gbrown128/wallie-pdb/README.md

# WALL-IE Power Distribution Board
Power Distribution Board for Team Congo's Bio Inspired Robots project, "WALL-IE".

Current Bio-Inspired Robots students please feel free to ask me questions about this design and options for your robot in the Issues section!
