gbrown128/wallie-pdb/PDF/cutoff-hardware.pdf

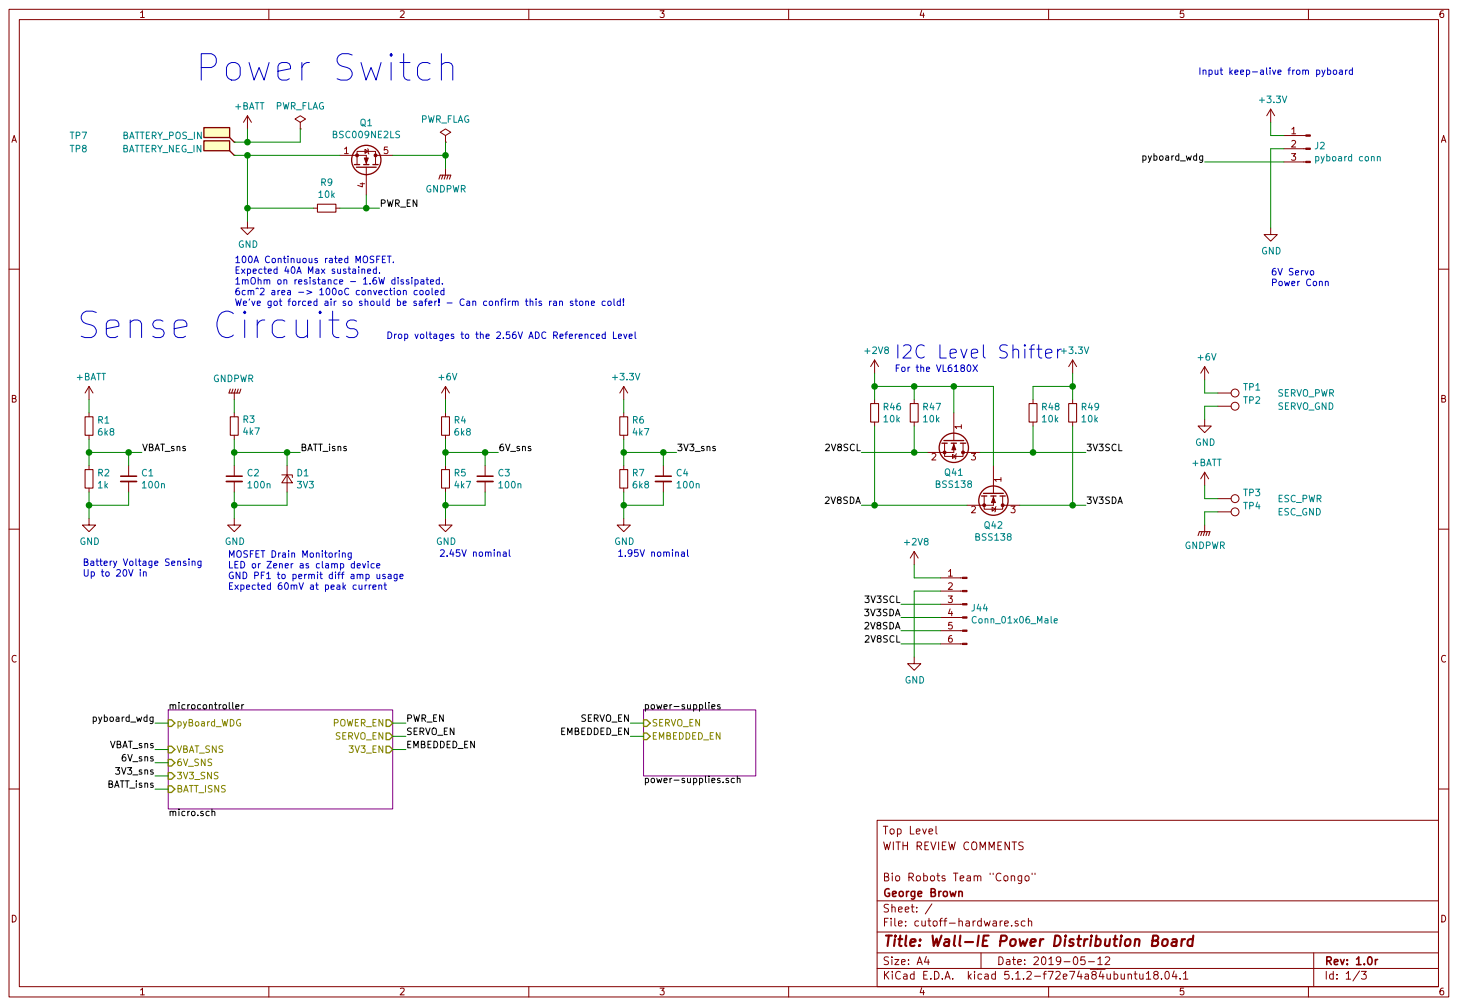
[picture p1: page 1]

Input keep-alive from pyboard

EMBEDDED_EN GND
100A Continuous rated MOSFET. Expected 40A Max sustained.

1mOhm on resistance - 1.6W dissipated. 6cm^2 area -> 100oC convection cooled We've got forced air so should be safer! - Can confirm this ran stone cold! SERVO_EN

LED or Zener as clamp device
GND PF1 to permit diff amp usage

Bio Robots Team "Congo" WITH REVIEW COMMENTS

File: cutoff-hardware.sch Sheet: / George Brown

Id: 1/3 Title: Wall-IE Power Distribution Board

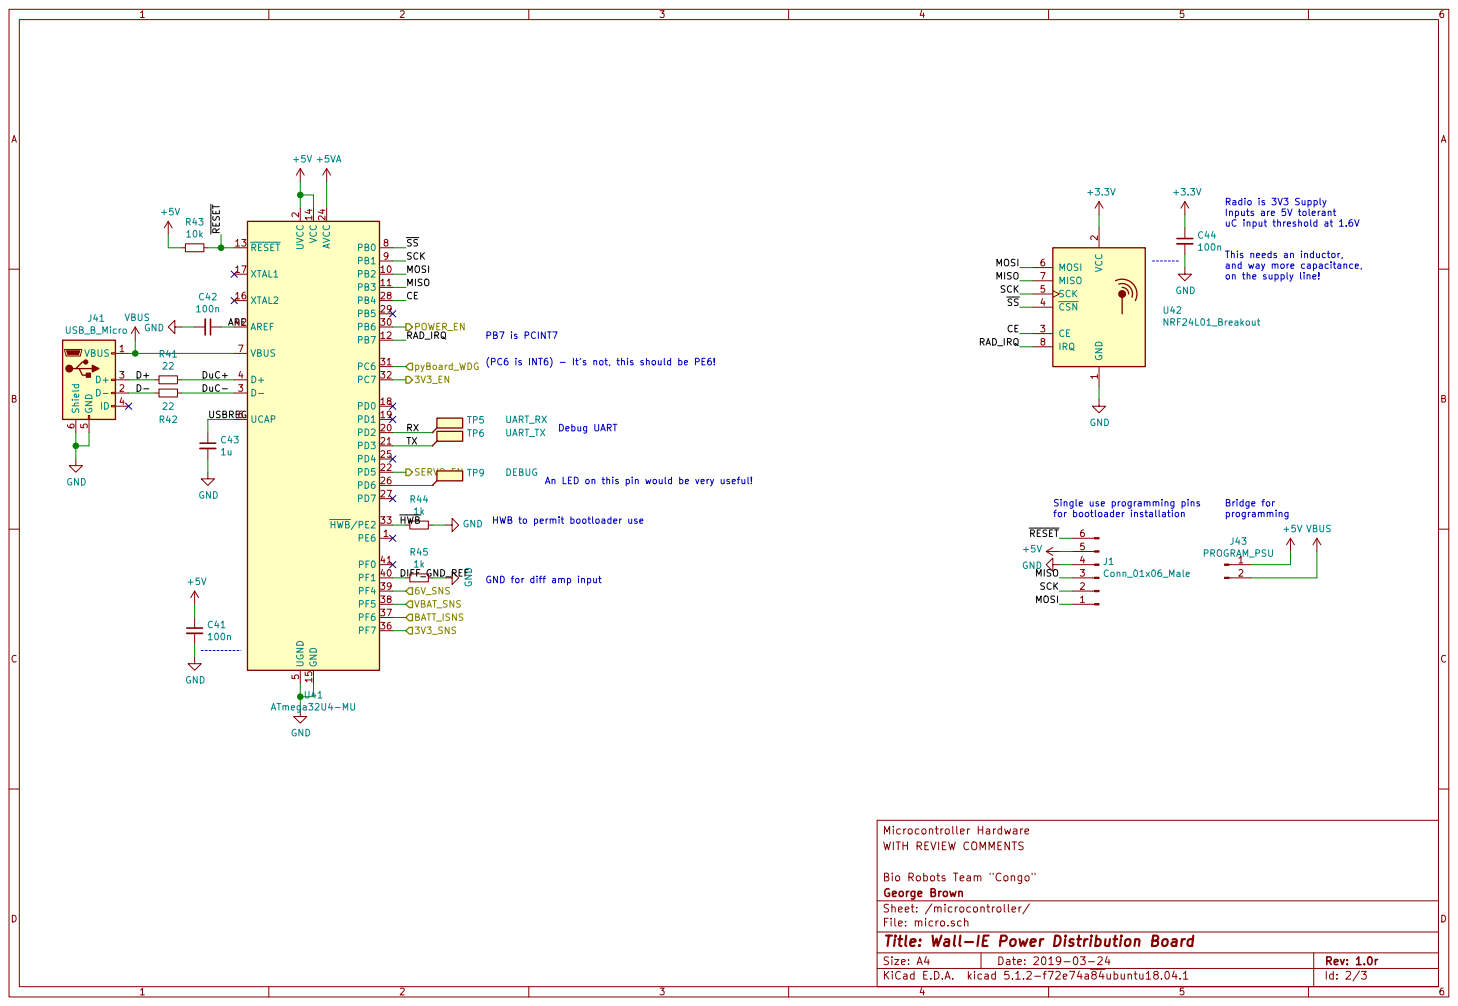
[picture p2: page 2]

Radio is 3V3 Supply
Inputs are 5V tolerant
uC input threshold at 1.6V

2 PD2 20 PD3 21 PD5 22 AVCC 24 PD4 25 PD6 26 PD7 27 PB4 28 PB5 29 D- 3 PB6 30 PC6 31 PC7 32 HWB/PE2 33 PF7 36 PF6 37 PF5 38 PF4 39 D+ 4 PF1 40 PF0 41 AREF 42 UGND

2 CE 3 CSN 4 SCK 5 MOSI 6 MISO 7

on the supply line!

GND for diff amp input PB7 is PCINT7 USBREG

An LED on this pin would be very useful!

RESETSingle use programming pins

HWB to permit bootloader use
+5V GND

Bio Robots Team "Congo" WITH REVIEW COMMENTS Microcontroller Hardware

File: micro.sch Sheet: /microcontroller/ George Brown

Id: 2/3 Title: Wall-IE Power Distribution Board

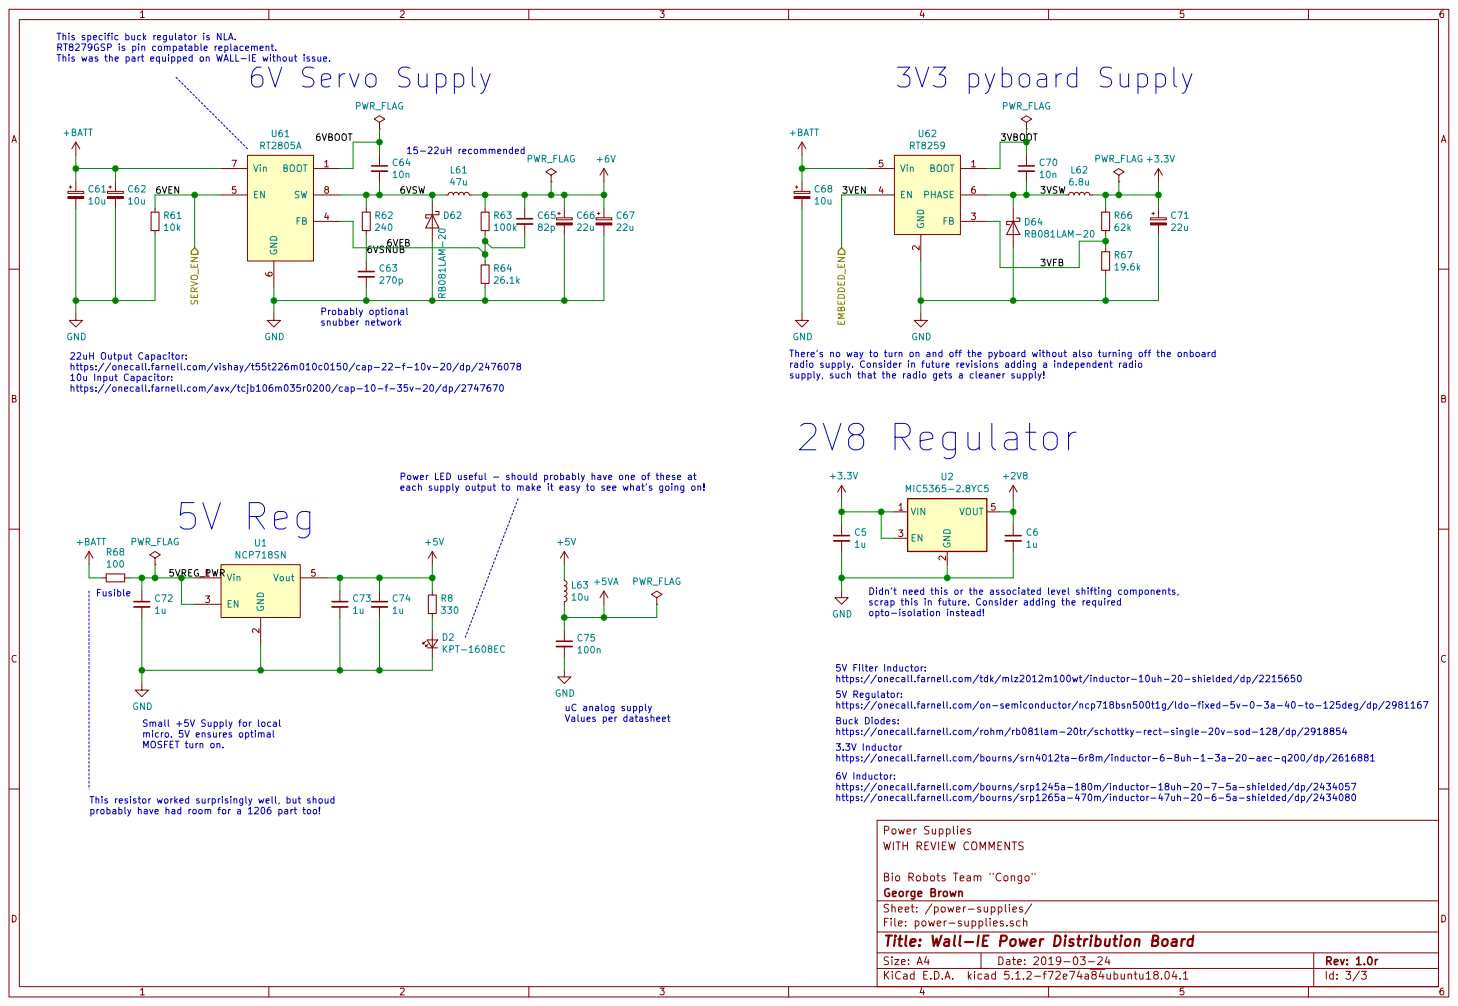
[picture p3: page 3]

This specific buck regulator is NLA.
RT8279GSP is pin compatable replacement.
This was the part equipped on WALL-IE without issue.

2 FB 3 EN 4 Vin 5 PHASE 6 U62 RT8259 R66

2 EN 3 VOUT 5 U2 MIC5365-2.8YC5 GND GND GND GND GND
22uH Output Capacitor:
https://onecall.farnell.com/vishay/t55t226m010c0150/cap-22-f-10v-20/dp/2476078
10u Input Capacitor:
https://onecall.farnell.com/avx/tcjb106m035r0200/cap-10-f-35v-20/dp/2747670 5VREG_PWR

There's no way to turn on and off the pyboard without also turning off the onboard
radio supply. Consider in future revisions adding a independent radio
supply, such that the radio gets a cleaner supply!
2V8 Regulator

Power LED useful - should probably have one of these at
each supply output to make it easy to see what's going on!

Didn't need this or the associated level shifting components,
scrap this in future. Consider adding the required
opto-isolation instead!

5V Filter Inductor: https://onecall.farnell.com/tdk/mlz2012m100wt/inductor-10uh-20-shielded/dp/2215650

5V Regulator:
https://onecall.farnell.com/on-semiconductor/ncp718bsn500t1g/ldo-fixed-5v-0-3a-40-to-125deg/dp/2981167
Buck Diodes: https://onecall.farnell.com/rohm/rb081lam-20tr/schottky-rect-single-20v-sod-128/dp/2918854

Small +5V Supply for local

3.3V Inductor https://onecall.farnell.com/bourns/srn4012ta-6r8m/inductor-6-8uh-1-3a-20-aec-q200/dp/2616881

This resistor worked surprisingly well, but shoud
probably have had room for a 1206 part too!

https://onecall.farnell.com/bourns/srp1265a-470m/inductor-47uh-20-6-5a-shielded/dp/2434080

Power Supplies
Bio Robots Team "Congo" WITH REVIEW COMMENTS

George Brown
Sheet: /power-supplies/
File: power-supplies.sch
Id: 3/3 Title: Wall-IE Power Distribution Board
