gbrown128/wallie-pdb/cutoff-hardware.kicad_pcb

## KiCad design cutoff-hardware.kicad_pcb (2019-05-12)

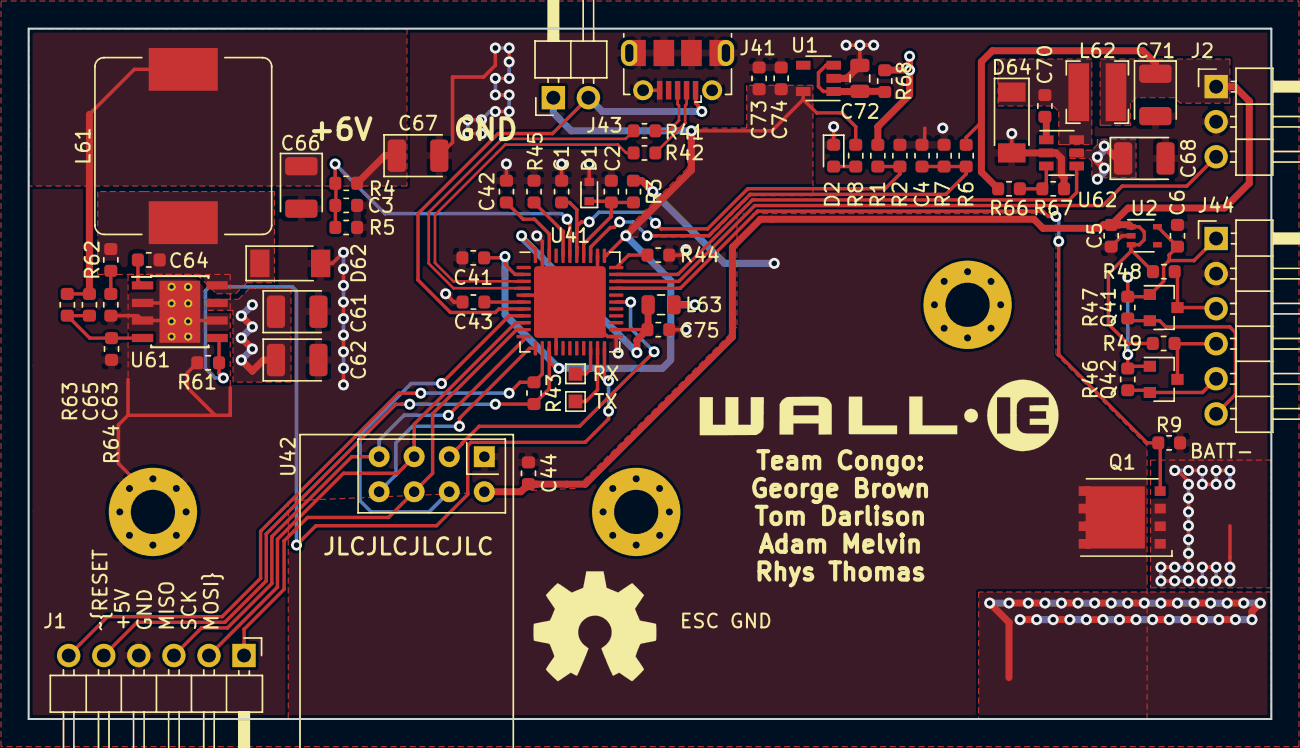
[picture p4: board cutoff-hardware.kicad_pcb from above]

Board: 2 copper layers, 90.0 x 50.0 mm, 72 parts (0 on the bottom side), 47 nets.

Parts:
C1, C2, C3, C4, C41, C42, C44, C75: 100n; C_0603_1608Metric
C5, C6, C43, C73, C74: 1u; C_0603_1608Metric
C61, C62, C68: 10u; CP_EIA-3528-21_Kemet-B
C63: 270p; C_0603_1608Metric
C64, C70: 10n; C_0603_1608Metric
C65: 82p; C_0603_1608Metric
C66, C67, C71: 22u; CP_EIA-3528-12_Kemet-T
C72: 1u; C_0805_2012Metric
D1: 3V3; D_SOD-523
D2: KPT-1608EC; LED_0603_1608Metric
D62, D64: RB081LAM-20; D_SOD-128
J1, J44: Conn_01x06_Male; PinHeader_1x06_P2.54mm_Horizontal
J2: pyboard conn; PinHeader_1x03_P2.54mm_Horizontal
J41: USB_B_Micro; USB_Micro-B_Molex-105017-0001
J43: PROGRAM_PSU; PinHeader_1x02_P2.54mm_Horizontal
L61: 47u; L_Bourns_SRP1265
L62: 6.8u; L_Bourns-SRN4012
L63: 10u; L_0805_2012Metric
Q1: BSC009NE2LS; TDSON-8-1
Q41, Q42: BSS138; SOT-23
R1, R4, R7: 6k8; R_0603_1608Metric
R2, R44, R45: 1k; R_0603_1608Metric
R3, R5, R6: 4k7; R_0603_1608Metric
R8: 330; R_0603_1608Metric
R9, R43, R46, R47, R48, R49, R61: 10k; R_0603_1608Metric
R41, R42: 22; R_0603_1608Metric
R62: 240; R_0603_1608Metric
R63: 100k; R_0603_1608Metric
R64: 26.1k; R_0603_1608Metric
R66: 62k; R_0603_1608Metric
R67: 19.6k; R_0603_1608Metric
R68: 100; R_0603_1608Metric
RX: UART_RX; TestPoint_Pad_1.0x1.0mm
TX: UART_TX; TestPoint_Pad_1.0x1.0mm
U1: NCP718SN; SOT-23-5
U2: MIC5365-2.8YC5; SOT-353_SC-70-5
U41: ATmega32U4-MU; QFN-44-1EP_7x7mm_P0.5mm_EP5.2x5.2mm
U42: NRF24L01_Breakout; nRF24L01_Breakout
U61: RT2805A; TI_SO-PowerPAD-8_ThermalVias
U62: RT8259; SOT-23-6

Connections:
+2V8: C6.1, J44.1, Q41.1, Q42.1, R46.1, R47.1, U2.5
+3V3: C5.1, C44.1, C71.1, J2.1, L62.2, R6.1, R48.1, R49.1, R66.1, U2.1, U2.3, U42.2
+5V: C41.1, C73.1, C74.1, J1.5, J43.1, L63.1, R8.1, R43.2, U1.5, U41.2, U41.14, U41.34
+5VA: C75.1, L63.2, U41.24, U41.44
+6V: C65.1, C66.1, C67.1, L61.2, R4.1, R63.1
+BATT: C61.1, C62.1, C68.1, R1.1, R68.2, U61.7, U62.5
/2V8SCL: J44.6, Q41.2, R47.2
/2V8SDA: J44.5, Q42.2, R46.2
/3V3SCL: J44.3, Q41.3, R48.2
/3V3SDA: J44.4, Q42.3, R49.2
/3V3_sns: C4.1, R6.2, R7.1, U41.36
/6V_sns: C3.1, R4.2, R5.1, U41.39
/BATT_isns: C2.1, D1.1, R3.1, U41.37
/EMBEDDED_EN: U41.32, U62.4
/PWR_EN: Q1.4, R9.1, U41.30
/SERVO_EN: R61.1, U41.22, U61.5
/VBAT_sns: C1.1, R1.2, R2.1, U41.38
/microcontroller/AREF: C42.1, U41.42
/microcontroller/CE: U41.28, U42.3
/microcontroller/D+: J41.3, R41.2
/microcontroller/D-: J41.2, R42.2
/microcontroller/DIFF_GND_REF: R45.2, U41.40
/microcontroller/DuC+: R41.1, U41.4
/microcontroller/DuC-: R42.1, U41.3
/microcontroller/MISO: J1.3, U41.11, U42.7
/microcontroller/MOSI: J1.1, U41.10, U42.6
/microcontroller/RAD_IRQ: U41.12, U42.8
/microcontroller/RX: RX.1, U41.20
/microcontroller/SCK: J1.2, U41.9, U42.5
/microcontroller/TX: TX.1, U41.21
/microcontroller/USBREG: C43.1, U41.6
/microcontroller/~HWB: R44.2, U41.33
/microcontroller/~RESET: J1.6, R43.1, U41.13
/microcontroller/~SS: U41.8, U42.4
/power-supplies/3VBOOT: C70.1, U62.1
/power-supplies/3VFB: R66.2, R67.1, U62.3
/power-supplies/3VSW: C70.2, D64.1, L62.1, U62.6
/power-supplies/5VREG_PWR: C72.1, R68.1, U1.1, U1.3
/power-supplies/6VBOOT: C64.1, U61.1
/power-supplies/6VFB: C65.2, R63.2, R64.1, U61.4
/power-supplies/6VSNUB: C63.1, R62.2
/power-supplies/6VSW: C64.2, D62.1, L61.1, R62.1, U61.8
/pyboard_wdg: J2.3, U41.31
GND: C1.2, C2.2, C3.2, C4.2, C5.2, C6.2, C41.2, C42.2, C43.2, C44.2, C61.2, C62.2, C63.2, C66.2, C67.2, C68.2, C71.2, C72.2, C73.2, C74.2, C75.2, D1.2, D2.1, D62.2, D64.2, J1.4, J2.2, J41.5, J41.6, J44.2, Q1.1, Q1.2, Q1.3, R2.2, R5.2, R7.2, R9.2, R44.1, R45.1, R61.2, R64.2, R67.2, U1.2, U2.2, U41.5, U41.15, U41.23, U41.35, U41.43, U41.45, U42.1, U61.2, U61.3, U61.6, U61.9, U62.2
GNDPWR: Q1.5, R3.2
unnamed: D2.2, R8.2
VBUS: J41.1, J43.2, U41.7
