gbrown128/wallie-pdb/(commit log)

2019-05-12 + Add reviewed version of the PDB design files. * Previous git history lives in the University of Southampton gitlab server!
    [cutoff-hardware-B_Cu.gbr, cutoff-hardware-B_Mask.gbr, cutoff-hardware-B_Paste.gbr, cutoff-hardware-B_SilkS.gbr, cutoff-hardware-Edge_Cuts.gbr, cutoff-hardware-F_Cu.gbr, cutoff-hardware-F_Mask.gbr, cutoff-hardware-F_Paste.gbr]
2019-05-12 + Add the KiCAD gitignore. - Strip out old unwanted KiCAD files.
